SilverLiningngo/lr-alphasense/(list of files, drawings)

Other design files:
Gas_Sampler Schematic + PCB files/Gas_Sampler-3.3V_LDO.SchDoc
Gas_Sampler Schematic + PCB files/Gas_Sampler-5V_Buck.SchDoc
Gas_Sampler Schematic + PCB files/Gas_Sampler-9V_Boost.SchDoc
Gas_Sampler Schematic + PCB files/Gas_Sampler-BME_280.SchDoc
Gas_Sampler Schematic + PCB files/Gas_Sampler-Flow_Sensor.SchDoc
Gas_Sampler Schematic + PCB files/Gas_Sampler-GPS.SchDoc
Gas_Sampler Schematic + PCB files/Gas_Sampler-Motor.SchDoc
Gas_Sampler Schematic + PCB files/Gas_Sampler-NOAA_Conn.SchDoc
Gas_Sampler Schematic + PCB files/Gas_Sampler-RFD_Radio.SchDoc
Gas_Sampler Schematic + PCB files/Gas_Sampler-Sensors.SchDoc
Gas_Sampler Schematic + PCB files/Gas_Sampler-Top.SchDoc
Gas_Sampler Schematic + PCB files/Gas_Sampler-Vin.SchDoc
Gas_Sampler Schematic + PCB files/Gas_Sampler.PrjPcb
