SilverLiningngo/lr-alphasense/LR-Alphasense-ESP32-Arduino.1/adc_lookup_table.cpp

#include "adc_lookup_table.h"

// ADC calibration lookup table For the first ESP32:
const float ADC_LUT[4096] = { 0,
35.8000,43.0000,48.6000,49.8000,51.0000,52.0000,53.2000,54.6000,55.8000,56.8000,58.0000,59.0000,60.4000,61.8000,62.8000,
64.0000,65.0000,66.4000,67.8000,68.8000,70.0000,71.2000,72.6000,73.8000,75.0000,76.0000,77.4000,78.8000,79.8000,81.0000,
82.0000,83.0000,84.0000,85.2000,86.4000,87.6000,88.8000,89.8000,90.8000,91.8000,93.0000,94.0000,95.0000,96.0000,97.4000,
98.8000,99.8000,100.8000,102.0000,103.0000,104.4000,105.8000,106.8000,107.8000,109.0000,110.0000,111.4000,112.6000,113.8000,114.8000,
115.8000,117.0000,118.0000,119.0000,120.2000,121.4000,122.6000,123.8000,124.8000,125.8000,126.8000,128.0000,129.0000,130.4000,131.8000,
133.0000,134.0000,135.6000,136.8000,138.0000,139.0000,140.6000,141.8000,143.0000,144.2000,145.4000,146.6000,147.8000,148.8000,149.8000,
150.8000,152.0000,153.0000,154.0000,155.0000,156.2000,157.4000,158.6000,159.8000,160.8000,161.8000,163.0000,164.0000,165.2000,166.4000,
167.6000,168.8000,169.8000,171.0000,172.0000,173.0000,174.2000,175.6000,176.8000,177.8000,179.0000,180.0000,181.4000,182.6000,183.8000,
185.0000,186.0000,187.2000,188.6000,189.8000,190.8000,192.0000,193.0000,194.0000,195.0000,196.0000,197.2000,198.2000,199.4000,200.6000,
201.6000,202.8000,203.8000,204.8000,205.8000,206.8000,207.8000,209.0000,210.0000,211.6000,212.8000,214.0000,215.0000,216.4000,217.8000,
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
699.0000,700.0000,701.2000,702.4000,703.8000,704.8000,706.0000,707.0000,708.2000,709.6000,710.8000,711.8000,713.0000,714.0000,715.4000,
716.6000,717.8000,718.8000,720.0000,721.2000,722.8000,723.8000,725.0000,726.2000,727.6000,728.8000,730.0000,731.2000,732.6000,733.8000,
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
};
