SilverLiningngo/lr-alphasense/(commit log)

2024-07-02 Initial commit as entered from source
    This doesn't compile, but committed as a reference. from "Observing volcanoes with drones: studies of volcanic plume chemistry with ultralight sensor systems" supplementary materials doc.
    [LR-Alphasense-ESP32-Arduino.1.ino]
2024-07-02 Updated LITTLEFS to LittleFS new arduino core esp
2024-07-02 Updated LEDC setup from ESP core 2.x to 3.x
    https://docs.espressif.com/projects/arduino-esp32/en/latest/migration_guides/2.x_to_3.0.html
    Not tried on hardware yet
2024-07-05 Updated pin naming convention, pin numbers
2024-07-06 Fix for GPS uart configuration
    Not sure why this is needed, but adding it fixed the no GPS reception, even in the Adafruit example sketch. Thx chatGPT
    [LR-Alphasense-ESP32-Arduino.1.ino]
2024-07-06 CO2 sensor working, Added error checking
    The s300 library is lame - it never returns a false when it talks to the CO2 sensor, not at .begin. it just returns the last value it received from the sensor. (ugh) So this code takes care of reacting to the loss of comms or presence.
    [LR-Alphasense-ESP32-Arduino.1.ino]
2024-07-06 Changed NC ADC to read battery voltage, added actual volts
    Changed the NC adc section to read the battery voltage divider pin. Also added a scaling factor so that the telemetry is now reporting actual battery volts.
2024-07-06 Little Batt println change
2024-07-06 Added basic HDC sensor reading, not logging yet
    Added the code, a tiny bit messy, will clean up later. It works, reading into global variables hdcHumidity and hdcTemperature currently not being logged though.
2024-07-07 Updated Pump motor PWM output, works
    More format changes from ESP core 2.x to 3.x
2024-07-10 Added lookup table to linearize the ADC for SO2 and Batt
    added external files adc_lookup_table.cpp and .h. Used self calibration method here to generate the lookup table: https://github.com/e-tinkers/esp32-adc-calibrate?tab=readme-ov-file
    This is for board SN2, will need to check the other boards to see if this should be done board-specific.
2024-07-10 Condensed serial reading code significantly
    Made the serial terminal menu into a function instead of individual else if lines duplicated for every serial input device. (removed hundreds of lines of redunant lines)
2024-07-10 Synchronized entire operations to GPS seconds PPS
    This was a lot of work to get right, but it now starts the loop exactly every two seconds synchronized on the GPS Pulse-Per-Second signal line. This replaces the unreliable delay(1000) at the end of the loop. It does not handle the GPS missing well, it should fall back to the millis counter, but will take care of that in the future. It's currently capturing GGA only
    [LR-Alphasense-ESP32-Arduino.1.ino]
2024-07-10 Changed humidity output to read from HDC instead of BME
    BME on board SN2 wasn't reading correctly, so using HDC humidity sensor instead
    [LR-Alphasense-ESP32-Arduino.1.ino]
2024-07-11 Fixed bluetooth line ending issue
    [LR-Alphasense-ESP32-Arduino.1.ino]
2024-07-14 Fixed continuous line behavior when no GPS lock
    When the GPS has no PPS lock, the telmetry now ends in a \n so each new set comes on a new line.
    [LR-Alphasense-ESP32-Arduino.1.ino]
2024-07-17 temperature variables write to file strings
2024-07-19 GPS logic rearranged and string rearranged, output working
    Made the GPS work more like Adafruit background, less complpicated, reading in one char per main loop, non-blocking. Previously was a blocking read waiting for PPS or millis. Now it uses library calls to get the date, time, lat/lon alt, fix quality and put it into the write_to_file_string. This is not yet evaluated for dealing with GPS errors/missing etc. It works when the GPS is working, that's all that's been tried.
    [LR-Alphasense-ESP32-Arduino.1.ino]
2024-07-19 Fixed data comments, added frame number
    [LR-Alphasense-ESP32-Arduino.1.ino]
2024-07-19 Fixed ChipID and printing it
    [LR-Alphasense-ESP32-Arduino.1.ino]
2024-07-19 Really fixed chipid to just use whole mac address
    The chipid (last 3 mac bytes) was not unique between the two ESP32s I have here
    [LR-Alphasense-ESP32-Arduino.1.ino]
2024-07-19 Disabled FLOW analog variable logging
2024-07-19 Added boot/run LED code, pinmodes cleanup
    LED comes on at the beginning of the Setup loop and turns off at the end. It flashes during normal operation; it turns on when sensor reading starts and turns off after data is written and output. Also moved the pinmodes around and made a #define for GPS_PPS_PIN
2024-07-20 Added persistent sensor serial number storage
    Added non-volatile preferences for SO2 sensor serial number as well as CO2 sensor serial. Also added serial terminal commands to get and set these. Added these to the data output comment line as well.
2024-07-20 Added printing a test error to the comments
    Just doing the SI voltage batt now, will add more later. Works.
    [LR-Alphasense-ESP32-Arduino.1.ino]
2024-07-23 First pass, not working right
    [LR-Alphasense-ESP32-Arduino.1.ino]
2024-07-25 Fixed ADC code, now internl calibrated
    Changed ADC internal calibration code to be functional. Commented out the Lookup Table. (adc_lookup_table.h) Still uses the pre 5.0 espressif IDK commands for ADC cali. Pretty close to accurate on BATT and SO2. Disabled the FLOW adc reading function. SI_voltage_pin_FLOW
    [LR-Alphasense-ESP32-Arduino.1.ino]
2024-08-04 Fixed setting serial numbers
    Problem was the number length for strcmp - was 15, should have been 13. Also changed letter case of the commands.
    [LR-Alphasense-ESP32-Arduino.1.ino]
2024-08-04 Changed name of ADC variable
    Changed incorrectly named voltage_sum to adc_sum.
2024-08-04 commit missing line from adc variable change
    missed removing a line
    [LR-Alphasense-ESP32-Arduino.1.ino]
2024-08-04 Added recording raw ADC - AMIDST MERGE WEIRDNESS
    This is a quick hack to get the raw uncalibrated ADC values of the SO2 sensor to save/telemeter for a simple system calibration test.
    Includes an adc global variable that probably should be removed later, bad practice. Do the ADC variables better?
    Was working,
2024-08-04 Cleaned up factory ADC stuff
2024-08-09 Added schematic and PCB files
    Made in Altium
    [Gas_Sampler-3.3V_LDO.SchDoc, Gas_Sampler-5V_Buck.SchDoc, Gas_Sampler-9V_Boost.SchDoc, Gas_Sampler-BME_280.SchDoc, Gas_Sampler-Flow_Sensor.SchDoc, Gas_Sampler-GPS.SchDoc, Gas_Sampler-Motor.SchDoc, Gas_Sampler-NOAA_Conn.SchDoc]
